Pooldeau/motorisation_porte_de_garage/README.md

Fabriquer un automatisme de porte de garage suite à une panne électronique de la carte d’origine, seul la mécanique a été conservée avec son moteur 24V.
Afin de garder les mêmes caractéristiques, il faut au minimum une télécommande, une protection enfant. Cette protection est assurée en maitrisant le courant passant dans le moteur.
La détection de fin d’ouverture et de fermeture est assurée par des fins de courses de type ILS.
La télécommande possède deux boutons pour l’ouverture et la fermeture de la porte de garage.
L’automatisme gère également l’éclairage du garage par deux boutons fixés sur le boitier.
